mGresset/beelieve_in_ourselves/image/diagramme_pieuvre.drawio.png

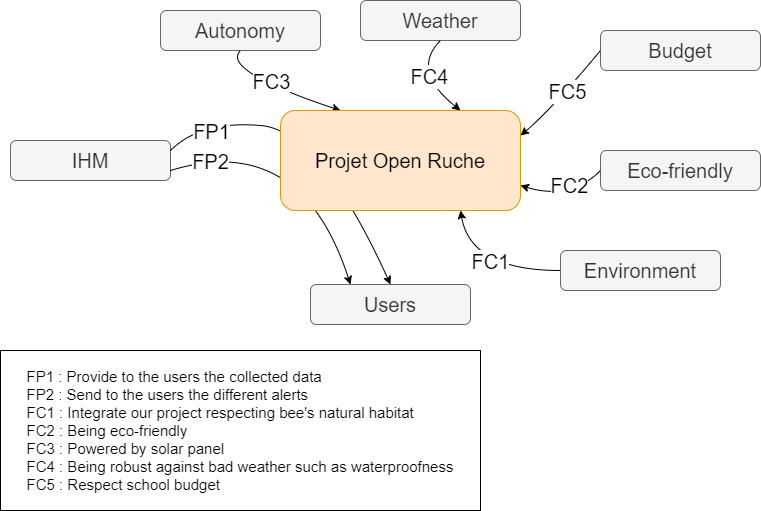
image/diagramme_pieuvre.drawio.png
