mGresset/beelieve_in_ourselves/image/ubidots1.jpg

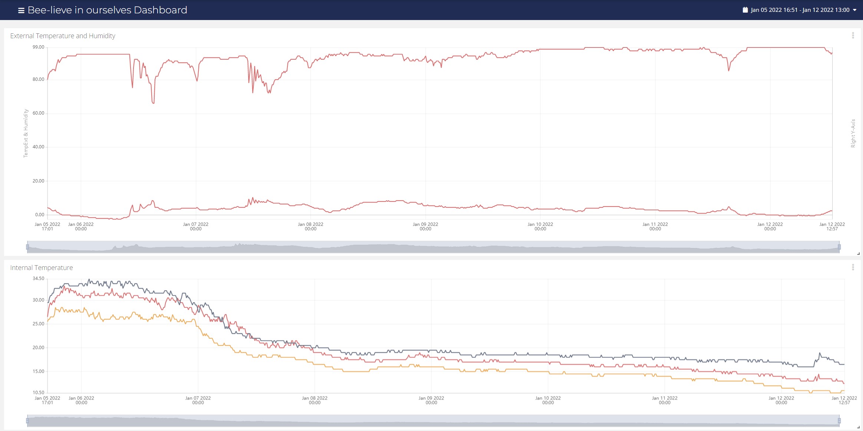
image/ubidots1.jpg
