mGresset/beelieve_in_ourselves/image/ubidots2.jpg

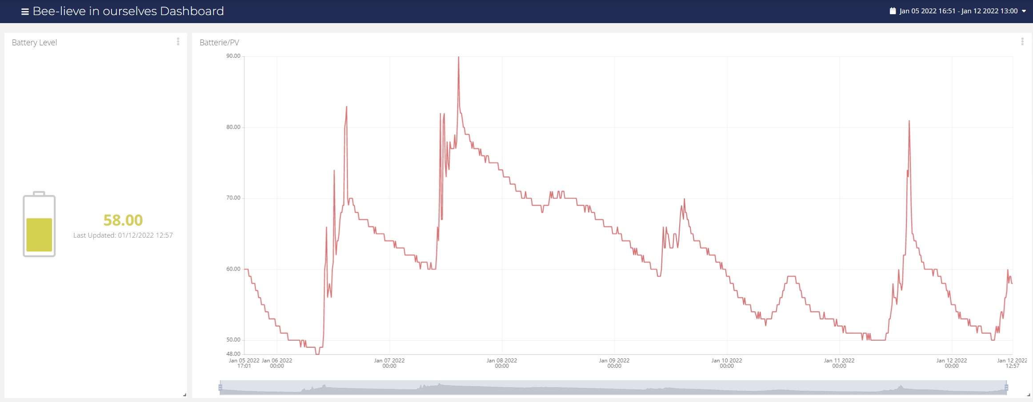
image/ubidots2.jpg
