mGresset/beelieve_in_ourselves/image/ubidots3.jpg

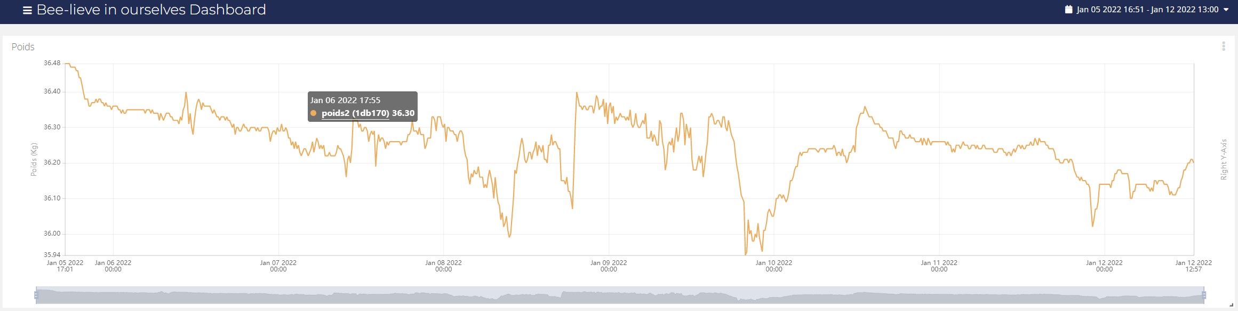
image/ubidots3.jpg
