mGresset/beelieve_in_ourselves/(commit log)

2021-10-04 Add files via upload
    Algo : Capteurs de température extérieur et intérieur
2021-10-04 Add files via upload
    Ajout des 3 capteurs de température intérieure
2021-10-06 Mise au propre de l'algo principal
2021-10-06 pont diviseur de tension pour adapter à l'arduino
2021-10-06 Add files via upload
    Algorithme propre : Fixer le problème d'envoie
    [algo.ino]
2021-10-06 Algo propre : fixer le problème d'envoie
    [algo.ino]
2021-10-06 ADC panneau solaire
2021-10-06 Ajout des lecteurs d'ADC
2021-10-25 Modification des formats de données envoyées
